TalhaYaman98/24W-Flayback/24WFlayback.pdf

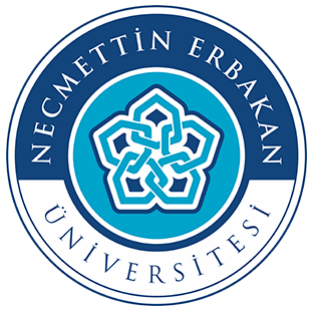
[picture p1: figure]

NECMETTİN ERBAKAN ÜNİVERSİTESİ

ELEKTRİK ELEKTRONİK MÜHENDİSLİĞİ

MÜHENDİSLİK FAKÜLTESİ

PROJE RAPORU
24W FLYBACK SMPS

MUHAMMET TALHA YAMAN

# FLYBACK SMPS 24W

## Tasarım girdileri:

Pout = 24W
Vout = 24V
Iout = 1A
Verim = %80
Vin = 230Vac +- %15 = 195Vac < Vin < 265Vac Anahtarlama frekansı= 100kHz
Kontrol entegresi = UC3844
ΔV(in,cap,ripple) = %15

## Giriş kapasitörü:

Vin(peak) = 195V * √2 = 276V | girişgerilimin tepe değeri
276V * 0.85 = 235V | kapasitör 276'dan 235'e düşecek
ΔV = 276V - 235V = 41V | ΔV ile kapasitör sığasınıhesaplayabiliriz
50Hz için 360° = 20ms, 180° = 10ms
276 * sin(wt) = -235 | -235 sinüs dalgasınınegatif alternansı
wt = -58.37° , 238° | 180°'den ötede olduğu için 238° kullanılır
Δt = ((238-90)/180)*10ms = 8.22ms | kapasitör şarj süresi

Vort = (276V + 235V) / 2 = 255V
Icap(deşarj) = Pin/Vort = (24W/0.8)/255 = 117.64 mA
C = (117.64mA*8.22ms)/41V = 23.58uF

## Trafo Dönüşüm Oranı

Vyansıyan = Vout * n, Vyansıyan 96V seçildi 96V = 24V * n , dönüşüm oranın = 4

## DutyCycle, Lpri, ILpeak

Vin(min) * D = Vyansıyan * (1 - D) 235V * D = 96 * (1 - D) , D = 0.290 Pin = Pout / verim = 24W / 0.8 = 30W D = (√(2*Pin*Lpri*f)) * 1/Vin
0.290 = (√(2*30W*Lpri*f)) * 1/235
Lpri = 0.774mH
Pin = 0.5 * L * (ILpeak)^2 * f = 0.5 * 0.774mH * (ILpeak)^2 * f ILpeak = 0.6A

## Is, Ipri, IRsense

Vcort = 255V, ILpeak = (Vcort / Lpri) * Dort * T
Dort = 0.182
Is = Ipri = IRsense = (1/√3) * ILpeak * √Dort = 0.148A (rms)

## Rsense

Vsense = 1V (UC3844)
Vsense = 1V --- Bcore = 0.3T
Vsense = ? --- Bcore = 0.2T , Vsense = 0.666V Rsense = Vsense/ILpeak = 1.11ohm P(Rsense) = IRsense^2 * 1.11ohm = 0.0243W

## Snubber Gücü, Diyot, TVS Diyot

Kaçak %1 olarak kabul edildi , Lk = 0.01 * 0.774mH = 7.44uH
P = 0.5 * 7.44uH * 0.6 * f = 0.223W
Psnubber > 0.233W olmalı, pratik olarak iki katıalınabilir Psnubber = 0.446W
TVS diyot yansıyan gerilimin en az iki katıolamalı, 200V diyot seçilir
375V girişgerilimi ve 200V TVS ile VDs(max) = 575V olur , US1m (1000V) uygundur

## Çıkış Diyotu

265V * √2 = 375V | girişgeriliminin max değeri
375V / 4 = 93.75V | seconder gerilimi
VD(peak) = 93.75 + 24V = 117.75V
ID(ort) = Io = 24W / 24V = 1A
PDloss = 0.8 * 1 = 0.8W

## Seconder Akımı

IL(peak) * n = Isec(peak) , 0.6 * 4 = 2.4A Isec(rms) = (1/√3) * 2.4 * √(1-Dort) = 1.253A

## Köprü Diyot

Pin = 30W , Vcap(ort)min = 255V Ireq(ort) = 30W / 255V = 117mA Id1 = Id2 = 117mA / 2 = 58.5mA Pd1 = 58.5mA * 1 = 58.5mW
4 * Pd1 = 234mW

## NTC, CMC

Iin(rms) = (30W / 195V) * (1 / 0.7) = 0.219A 0.7 tahmini güç faktörü NTC : 5D-9
CMC : Würth 744822220

## Çıkış Kapasitörü

Ico(rms) = √(Isec^2 - Io^2) = √(1.253^2 - 1^2) = 0.754A

## Mosfet

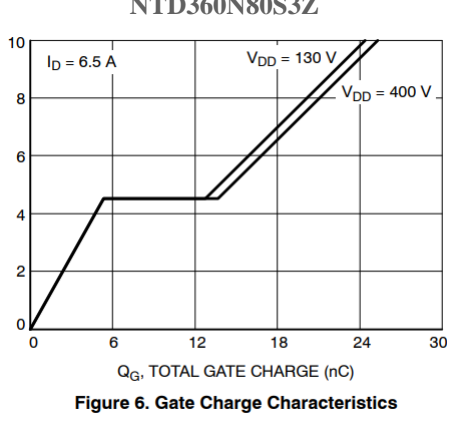
[picture p2: figure]

VDs(max) = 375 + 200 = 575V mosfet üzerine düşen gerilim NTD360N80S3Z uygundur , 800V
Vgs(ort) = (4.5 + 0) / 2 = 2.25V
Igate = (15 - 2.25) / 22 = 0.58A | Gate direnci 22ohm seçildi
Δt1 = 5nC / 0.58 = 8.6ns | Aralık 1

Igate = (15 - 4.5) / 22 = 0.477A
Δt2 = 10nC / 0.477 = 20.95ns Aralık 2

Vgs(ort) = (10 + 4.5) / 2 = 7.25V
Igate = (15 - 7.25) / 22 = 0.352A
Δt3 = 9nC / 0.352 = 25.54ns | Aralık 3
Δt1 + Δt2 + Δt3 = 55.09ns

UC3844 output rise time = 150ns
55.09ns < 150ns , mosfet entegreden daha hızlı entegre mosfeti rahat sürer

NTD360N80S3Z

## Trafo

Primer:Seconder | Pout | Ipri(rms) | Isec(rms) | Lpri | IL(peak)
4:1 | 24W | 0.148A | 1.253A | 0.774mh | 0.6A
Trafo seçimi : EE2525F , Ae = 51.8 , Aw = 95.3
L * IL(peak) = Npri * Φ = N * B * Ae
0.744mH * 0.6A = Npri * 0.2T * 51.8 * 10^-6 ,
Npri = 44.82 , tam olmasıiçin 48 seçelim

Npri = 48 : Nsec = 12
J = 5A/mm^2 ,bir mm kareden kaç amper geçeceği
Primer | Seconder
5A | --- 1mm^2 | 5A | --- 1mm^2
0.148A --- 0.0296mm^2 | 1.253A --- 0.25mm^2
48 * 0.0296 = 1.42 | 12 * 0.25 = 3
1.42 + 3 = 4.42
4.42 / 95.3 = 0.04 , %4 , %4 < %25 , nüveye rahat sığar, nüve küçültülebilir
π*r^2 = 0.0296mm^2 | π*r^2 = 0.25mm^2
r = 0.097, 2r = 0.19 | r = 0.282, 2r = 0.564 | Tel çapı
N1 : 48Ts x 1P x 0.19mm 2UEW−F
N2 : 12Ts x 3P x 0.564mm TIW

YardımcıSargı: Nys = Nsec * (Vys/Vsec) , Nys = 7.5 , 7 olarak kabul edelim N3 : 7Ts x 1P x 0.564mm 2UEW−F

## DC bara

Istart(min) = (195 * √2) / R | entegre startup akımının (0.5mA) üstünde olmalı
R = 300k seçelim | 3 adet 100k direnç, 1206 kılıf direnç
Istart(min) = (195 * √2) / 300k = 0.92mA
P(Rmax) = ((375 - 15)/3)^2 / 100k = 0.143W

## RT/CT

fosc = 1.72 / (R * C)
5kohm < R < 100kohm
1nF < C < 100nF
100kHz için C = 1.7nF , R = 10kohm fosc = 1.72 / (10kohm * 1.7nF) = 101176.47
