TalhaYaman98/24W-Flayback/flyback1.PNG

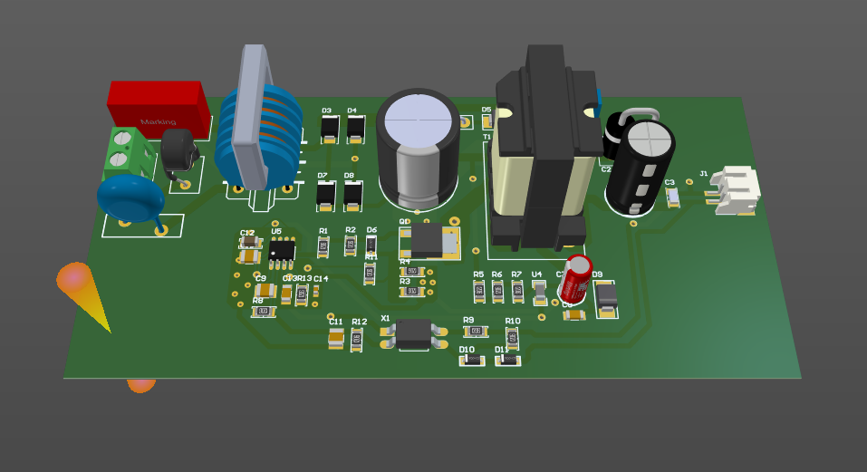
flyback1.PNG
