TalhaYaman98/24W-Flayback/flyback2.PNG

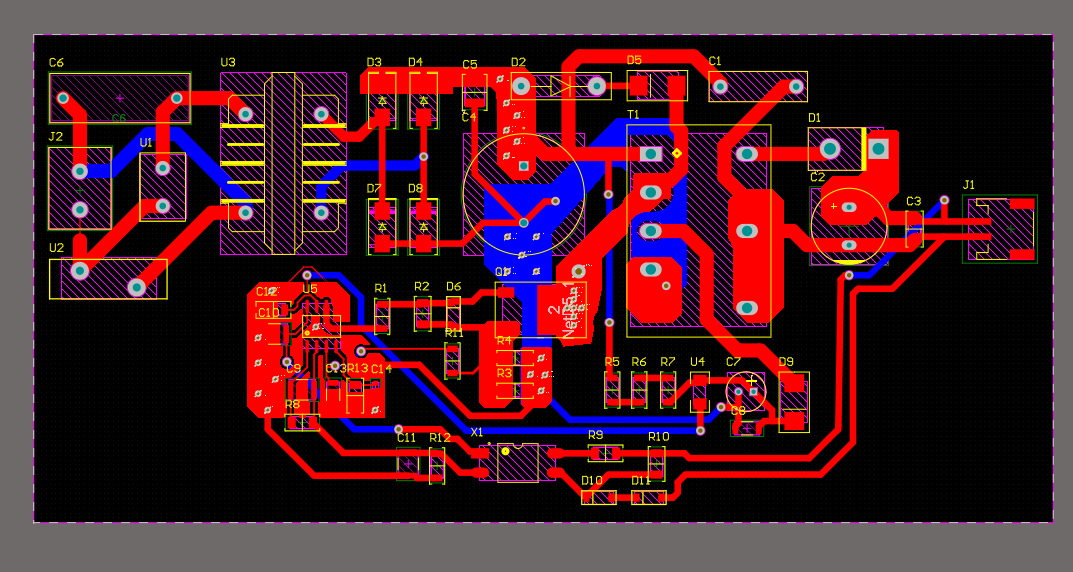
flyback2.PNG
