TalhaYaman98/24W-Flayback/flyback3.PNG

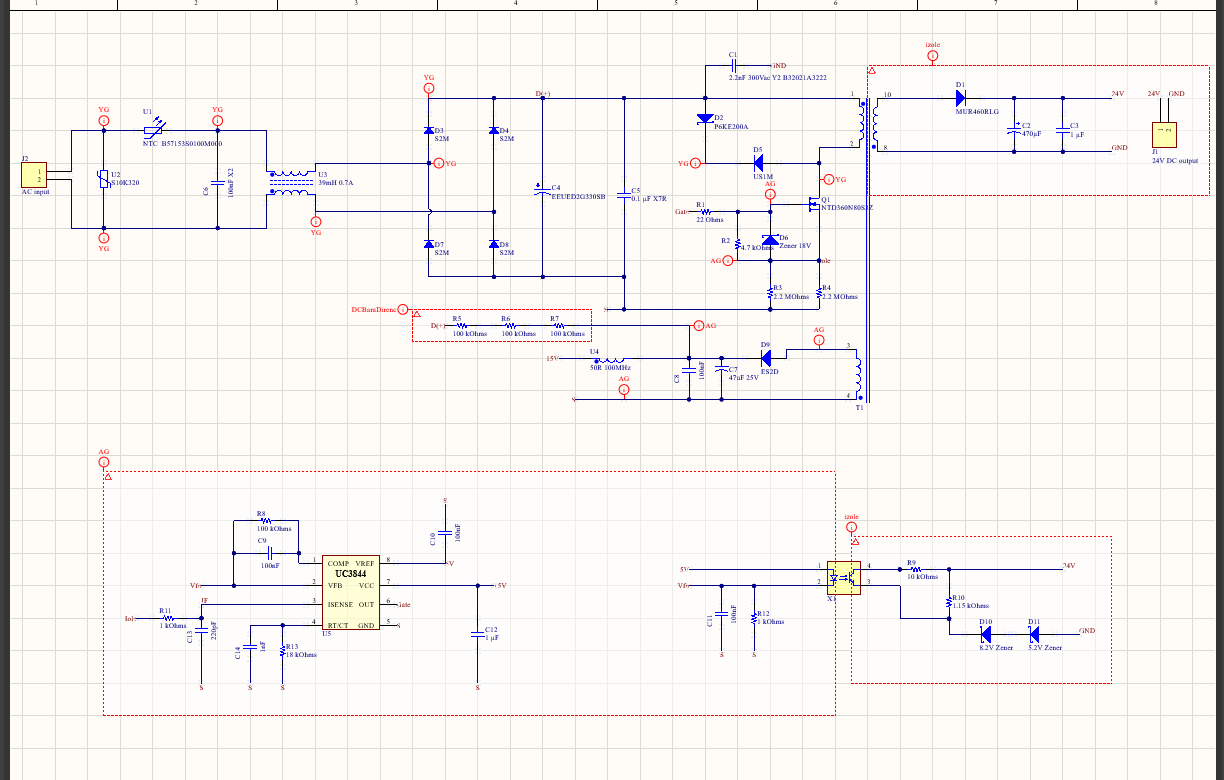
flyback3.PNG
