TalhaYaman98/24W-Flayback/(list of files, drawings)

Other design files:
Flyback_SMPS/ProjePower.PrjPcb
Flyback_SMPS/Sheet1.SchDoc
